Senvor/Starbie/assets/JLCPCB.png

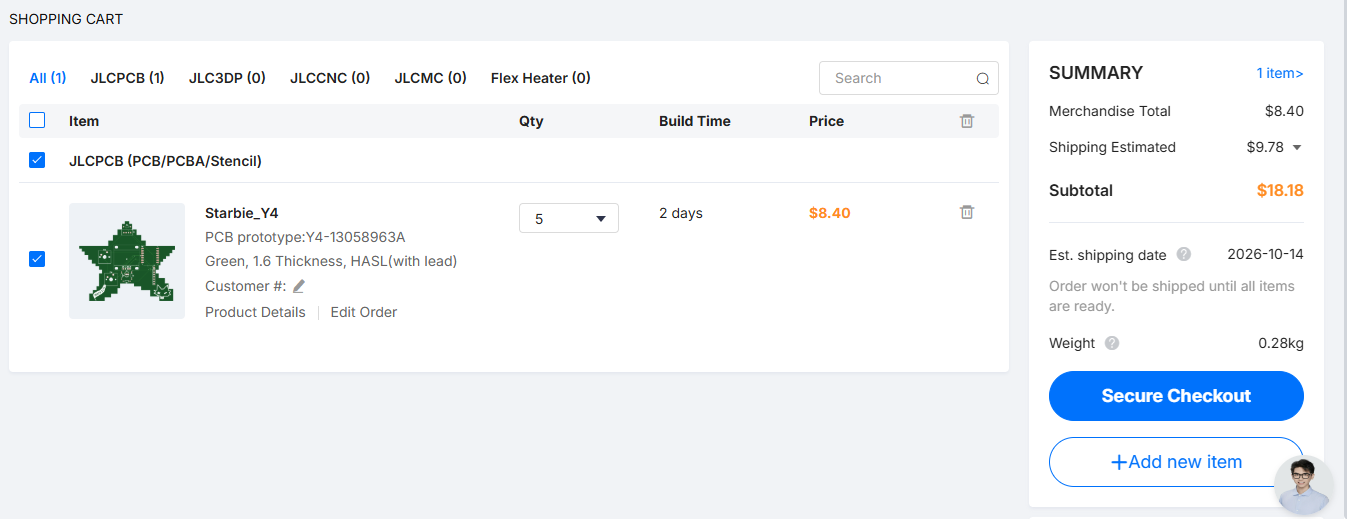
assets/JLCPCB.png
