Senvor/Starbie/assets/Starbie.png

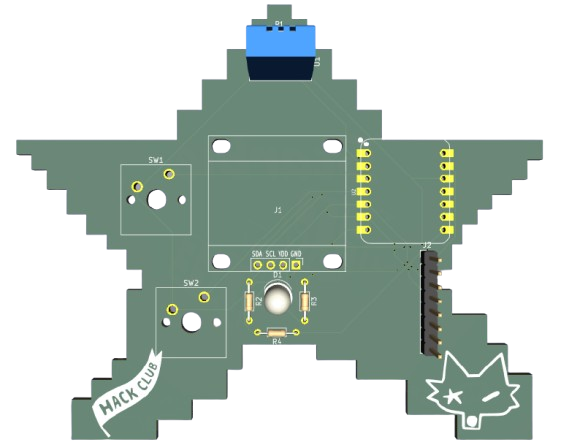
assets/Starbie.png
