Senvor/Starbie/BOM.md

# Starbie – bill of materials

<!-- Generated by Half Life from project cmuv7474u0e9g01sm617a2cpe. Edits here are overwritten on the next sync. -->
<!-- Generated: 2026-10-12T03:57:32.023Z -->

> [!NOTE]
> This parts list is mirrored from [Half Life](https://halflife.hackclub.com). Editing it here will not change the platform's copy, and the next sync overwrites this file.

| Week | Tier | Parts funding |
| --- | --- | --- |
| Week 1 | Tier 1 | $30.00 |

| Part | What it's for | Qty | Unit | Total | Vendor |
| --- | --- | --- | --- | --- | --- |
| [PCB](https://jlcpcb.com) | main thing | 1 | $18.00 | $18.00 | [JLCPCB](https://jlcpcb.com) |
| **Parts subtotal** | — | — | — | **$18.00** | — |
| **Tax & shipping** | — | — | — | **$0.00** | — |
| **Total** | — | — | — | **$18.00** | — |

$12.00 left of the tier's funding.
