Senvor/Starbie/pcb/Starbie.kicad_pcb

## KiCad design pcb/Starbie.kicad_pcb (2026-10-23)

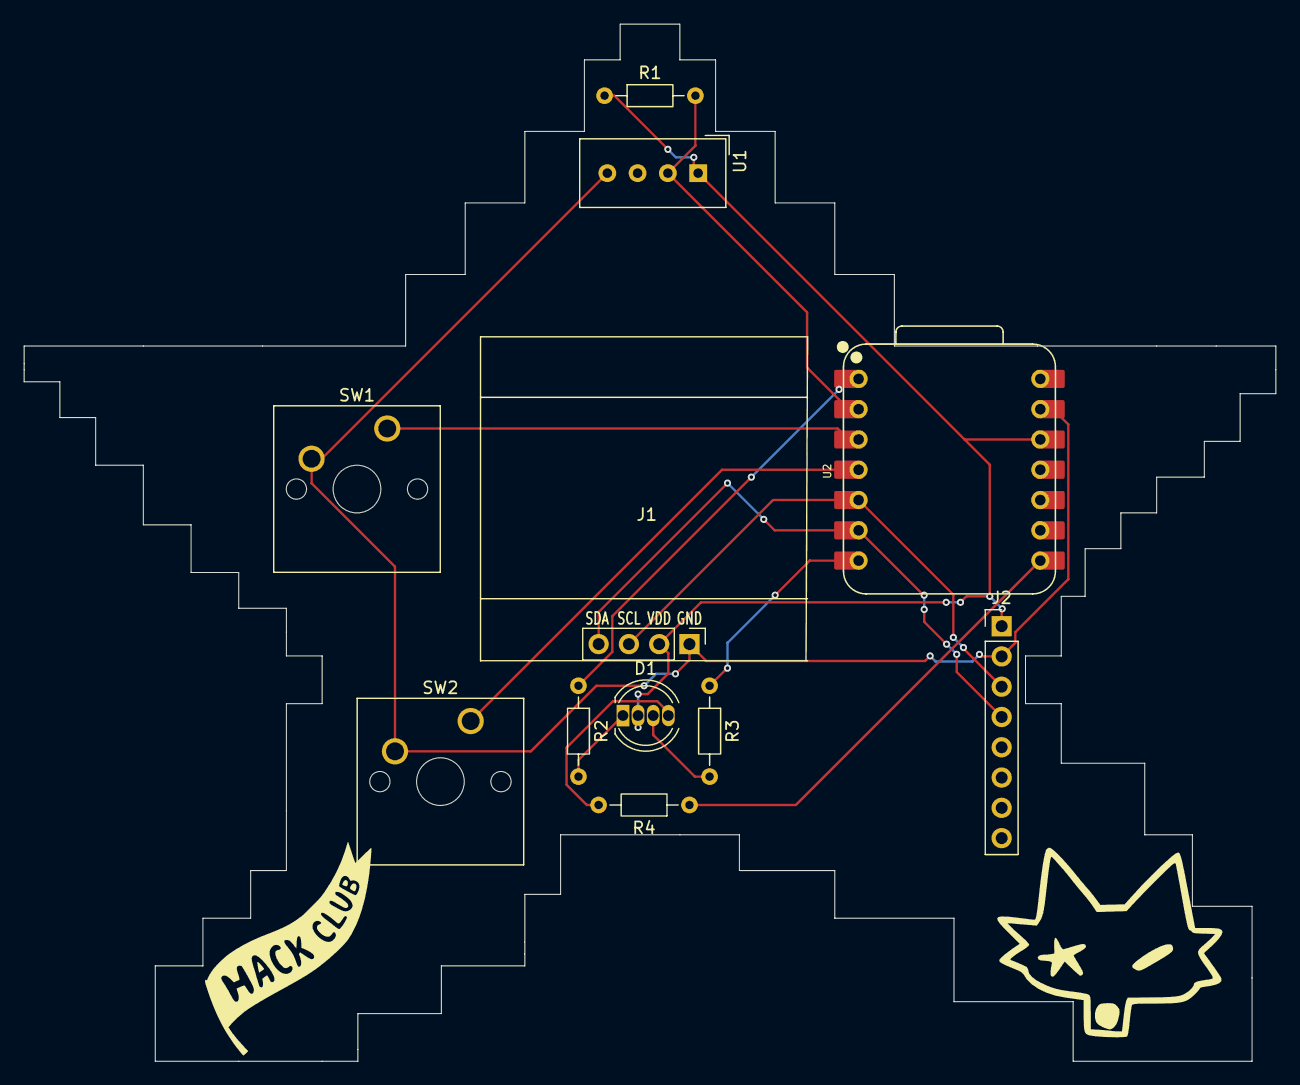
[picture p7: board Starbie.kicad_pcb from above]

Board: 2 copper layers, 105.0 x 87.0 mm, 11 parts (0 on the bottom side), 13 nets.

Parts:
D1: LED_RGB; LED_D5.0mm-4_RGB
J1: Conn_01x04_Pin; Display_128x64_096_I2C
J2: Conn_01x08_Pin; PinHeader_1x08_P2.54mm_Vertical
R1: 10k; R_Axial_DIN0204_L3.6mm_D1.6mm_P7.62mm_Horizontal
R2, R3, R4: 330; R_Axial_DIN0204_L3.6mm_D1.6mm_P7.62mm_Horizontal
SW1, SW2: SW_Push; SW_Cherry_MX_1.00u_PCB
U1: DHT11; Aosong_DHT11_5.5x12.0_P2.54mm
U2: XIAO-ESP32-C3-SMD; XIAO-ESP32-C6-DIP

Connections:
+3.3V: D1.2 (A), J1.2, J2.1, R1.1, U1.1 (VDD), U2.12 (3V3_OUT)
/DHT11 DATA: R1.2, U1.2 (DATA), U2.2 (D1)
/GPIO2: SW1.1, U2.3 (D2)
/GPIO3: SW2.1, U2.4 (D3)
/LED_B: R4.1, U2.8 (D7)
/LED_G: R3.1, U2.7 (D6)
/LED_R: R2.1, U2.1 (D0)
/SCL: J1.3, J2.3, U2.5 (D4)
/SDA: J1.4, J2.4, U2.6 (D5)
GND: J1.1, J2.2, SW1.2, SW2.2, U1.4 (GND), U2.13 (GND)
unnamed: D1.4 (BK), R4.2
unnamed: D1.3 (GK), R3.2
unnamed: D1.1 (RK), R2.2
