Senvor/Starbie/(commit log)

2026-10-12 Add lock file for Starbie schematic with hostname and username
2026-10-12 fix image sizing in README for schematic and JLCPCB
2026-10-20 Add BOM.csv for bill of materials and remove outdated BOM.md
2026-10-21 Update BOM.csv format and remove outdated README note
2026-10-21 Add detailed Bill of Materials with supplier links and costs
2026-10-23 Refactor LED properties and update designators in PCB and schematic files
2026-10-24 Update Bill of Materials and enhance README with controls and status LED details
2026-11-10 Update link for Custom Starbie PCB in BOM.csv
2026-11-10 Change price of Custom Starbie PCB to $20.22
    Updated the price of Custom Starbie PCB in BOM.csv.
2026-11-10 Update supplier for Custom Starbie PCB entry
2026-11-14 BOM: real shipping from Robu, Hubtronics, Meckeys; Robu PCB quote image
2026-11-14 Replace PCB image with full 3D render of assembled board
2026-11-14 README: 3D render on top, KiCad PCB design back in PCB section, drop old board image and status line
